dennaaa/LoRa_Node/CAMOutputs/Assembly/LoRa_Node_Schematic.txt

Stückliste exportiert aus C:/Users/sohns/Documents/EAGLE/projects/LoRa_Node/LoRa_Node_Schematic.sch am 22.01.2021 11:20

Qty Value              Device             Package                              Parts                            Description                                                                            AVAILABILITY BUILT_BY    COPYRIGHT                                                   DATASHEET                                                                             DESCRIPTION                                                                       DIGI-KEY_PART_NUMBER MANUFACTURER        MANUFACTURER-PN  MANUFACTURER_PART_NUMBER MANUFACTURER_PN MANUFACTURE_PN MF                  MP                 PACKAGE                    POPULARITY PRICE PURCHASE-URL                                                        SOURCELIBRARY               SPICEPREFIX TP_SIGNAL_NAME VENDOR           VOLTAGE
1                      LEDCHIP-LED0805    CHIP-LED0805                         LED1                             LED                                                                                                                                                                                                                                                                                                                                                                                                                                                                                                                                     68                                                                                                                                                                  
2                      PINHD-1X12-CB      1X12-CB                              JP1, JP2                         PIN HEADER                                                                                                                                                                                                                                                                                                                                                                                                                                                                                                                                                                                                                                                                                                  
1   0868AT43A0020E     0868AT43A0020E     XCVR_0868AT43A0020E                  ANT1                             Antenna 868mhz For Ti Cc11xx                                                                                                                                                                                                                                       868MHz Chip RF Antenna 858MHz ~ 878MHz -1dBi Solder Surface Mount                712-1399-1-ND                                                                                                     Johanson Technology 0868AT43A0020E     None                                        https://pricing.snapeda.com/search/part/0868AT43A0020E/?ref=eda                                                                                    
1   0p3                C-EUC0402          C0402                                C19                              CAPACITOR, European symbol                                                                                                                                                                                                                                                                                                                                               Johanson Technology                                           500R07S0R3BV4T                                                                                   18                                                                                                               C                                                  
1   100k               R-EU_R0402         R0402                                R6                               RESISTOR, European symbol                                                                                                                                                                                                                                                                                                                                                                                                                                                                                                               0                                                                                                                R                                                  
8   100n               C-EUC0402          C0402                                C4, C5, C6, C7, C8, C9, C11, C21 CAPACITOR, European symbol                                                                                                                                                                                                                                                                                                                                                                                                                                                                                                              18                                                                                                               C                                                  
3   10k                R-EU_R0402         R0402                                R4, R5, R7                       RESISTOR, European symbol                                                                                                                                                                                                                                                                                                                                                                                                                                                                                                               0                                                                                                                R                                                  
2   10u                C-EUC0603          C0603                                C15, C20                         CAPACITOR, European symbol                                                                                                                                                                                                                                                                                                                                                                                                                                                                                                              73                                                                                                               C                                                  
1   18n                INDUCTOR_0402_SMD  R0402                                L2                                                                                                                                                                                                                                                                                                                                                                                                        Johanson Technology                                           L-07C18NJV6T                                                                                                                                                                                                                                                         
1   1M                 R-EU_R0402         R0402                                R1                               RESISTOR, European symbol                                                                                                                                                                                                                                                                                                                                                                                                                                                                                                               0                                                                                                                R                                                  
1   1k                 R-EU_R0402         R0402                                R8                               RESISTOR, European symbol                                                                                                                                                                                                                                                                                                                                                                                                                                                                                                               0                                                                                                                R                                                  
3   1u                 C-EUC0402          C0402                                C10, C13, C14                    CAPACITOR, European symbol                                                                                                                                                                                                                                                                                                                                                                                                                                                                                                              18                                                                                                               C                                                  
2   20p                C-EUC0402          C0402                                C1, C2                           CAPACITOR, European symbol                                                                                                                                                                                                                                                                                                                                                                                                                                                                                                              18                                                                                                               C                                                  
1   32.768KHZ          ABS07-32.768KHZ-T  XTAL_ABS07-32.768KHZ-T               Y1                               ABS07 Series 32.768 kHz ±20 ppm 12.5 pF -40 to +85 °C SMT Low Profile Crystal                                                                                                                                                                                      32.768kHz ±20ppm Crystal 12.5pF 70 kOhms 2-SMD, No Lead                          535-9542-1-ND                                                                                                     Abracon             ABS07-32.768KHZ-T  SMD-2 Abracon LLC                           https://pricing.snapeda.com/search/part/ABS07-32.768KHZ-T/?ref=eda                                                                                 
1   330R               R-EU_R0402         R0402                                R3                               RESISTOR, European symbol                                                                                                                                                                                                                                                                                                                                                                                                                                                                                                               0                                                                                                                R                                                  
1   3p9                C-EUC0402          C0402                                C18                              CAPACITOR, European symbol                                                                                                                                                                                                                                                                                                                                               Johanson Technology                                                           500R07S3R9BV4T                                                                   18                                                                                                               C                                                  
1   4n7                C-EUC0805          C0805                                C3                               CAPACITOR, European symbol                                                                                                                                                                                                                                                                                                                                               KEMET               C0805C472KDRACTU                                                                                                                           88                                                                                                               C                                           1kV    
4   4u7                C-EUC0603          C0603                                C12, C16, C17, C22               CAPACITOR, European symbol                                                                                                                                                                                                                                                                                                                                                                                                                                                                                                              73                                                                                                               C                                                  
1   AP2112K-3.3        AP2112K-3.3        SOT95P285X140-5N                     U3                               AP2112 Series 0.6 A 3.3 V Fixed Output SMT LDO Linear Regulator - SOT23-5 Check prices Good                                                                                                                                                                        Linear Voltage Regulator IC 1 Output 600mA SOT-25                                                                                                                                                  Diodes Inc.         AP2112K-3.3        SOT-753 Diodes Inc.                   None  https://pricing.snapeda.com/search/part/AP2112K-3.3TRG1/?ref=eda                                                                                   
1   ATSAMD21G18A-AU    ATSAMD21G18A-AU    TQFP48_7X7MC_MCH                     U1                                                                                                                                   EMA_Molly   Copyright (C) 2018 Accelerated Designs. All rights reserved                                                                                                                                                                                                                                   ATSAMD21G18A-AU                                                                                                                                                                                                Microchip_2019-08-23_25                                Microchip               
1   B2B-PH-K-S(LF)(SN) B2B-PH-K-S(LF)(SN) JST_B2B-PH-K-S(LF)(SN)               J3                               PH Series 2 Position 2 mm Pitch Through Hole Top Entry Shrouded Header Check prices    Good                                                                                                                                                                        Connector Header Through Hole 2 position 0.079 (2.00mm)                                                                                                                                            JST Sales           B2B-PH-K-S(LF)(SN) None                                  None  https://pricing.snapeda.com/search/part/B2B-PH-K-S(LF)(SN)/?ref=eda                                                                                
1   BLM18PG471SN1D     BLM18PG471SN1D     IND_BLM18_0603_MUR                   L1                                                                                                                                   EMA_UL_Team                                                                                                                                                                                                                                                                                               BLM18PG471SN1D                                                                                                                                                                                                 Murata_2010-01-01IND_BLM                               MURATA                  
1   KMR231NGLFS        KMR231NGLFS        SW_KMR231NGLFS                       S1                               Tactile Switch SPST-NO Top Actuated Surface Mount  Check prices                        Good                                                                                                                                                                        Tactile Switch SPST-NO Top Actuated Surface Mount                                                                                                                                                  C&K Components      KMR231NGLFS        None                                  None  https://pricing.snapeda.com/search/part/KMR211NGLFS/?ref=eda                                                                                       
1   MBR120VLSFT1G      MBR120VLSFT1G      SDO_SOD-123FL_ONS                    D2                                                                                                                                   EMA_Cory    Copyright (C) 2018 Accelerated Designs. All rights reserved https://www.onsemi.com/pub/Collateral/MBR120VLSFT1-D.PDF                                                                                                                                                                          MBR120VLSFT1G                                                                                                                                                                                                  ON_Semiconductor_2020-09-15                            ON Semiconductor        
1   MCP73831-2ACI/OT   MCP73831-2ACI/OT   SOT95P280X145-5N                     U4                               Charge Management Controller Check prices                                              Good                                                                                                                                                                        Charger IC Lithium Ion/Polymer SOT-23-5                                                                                                                                                            Microchip           MCP73831-2ACI/OT   SOT-23 Microchip                      None  https://pricing.snapeda.com/search/part/MCP73831T-2ACI/OT/?ref=eda                                                                                 
2   MOUNT-HOLE2.5      MOUNT-HOLE2.5      MICROBUILDER_MOUNTINGHOLE_2.5_PLATED H1, H2                                                                                                                                                                                                                                                                                                                                                                                                                                                                                                                                                                                                                                                                                                                                       
1   PRTR5V0U2X,215     PRTR5V0U2X,215     SOT143B                              D1                               Ultra low capacitance double rail-to-rail ESD protection diode Check prices            Good                                                                                                                                                                        Clamp Ipp Tvs Diode Surface Mount SOT-143B                                                                                                                                                         Nexperia USA Inc.   PRTR5V0U2X,215     TO-253-4 Nexperia USA Inc.            None  https://pricing.snapeda.com/search/part/PRTR5V0U2X,215/?ref=eda                                                                                    
1   RFM95W-868S2SMALL  RFM95W-868S2SMALL  MICROBUILDER_RFMHCW_SMT              U2                               RFM95(W) - Low Power Long Range Transceiver Module V1.0 Check prices                                                                                                                                                                                                                                                                                                                                                                                                                                                                                                                                                                                                                                        
1   SHT40-AD1B-R2      SHT40-AD1B-R2      SHT4X_SEN                            U5                                                                                                                                   EMA_Cory    Copyright (C) 2018 Accelerated Designs. All rights reserved https://www.mouser.com/datasheet/2/682/Sensirion_10272020_Datasheet_SHT4x-1919523.pdf                                                                                                                                             SHT40-AD1B-R2                                                                                                                                                                                                  Add_to_database_2020-11-16                             Sensirion               
2   TPTP10R            TPTP10R            TP10R                                TP1, TP2                         Test pad                                                                                                                                                                                                                                                                                                                                                                                                                                                                                                                                3                                                                                                                                                                   
1   ZX62D-B-5PA8       ZX62D-B-5PA8       HIROSE_ZX62D-B-5PA8                  J1                               CONN RCPT USB Check prices                                                             Bad                                                                                                                                                                         USB - micro B USB 2.0 Receptacle Connector 5 Position Surface Mount, Right Angle  Through Hole                                                                                                                         Hirose             ZX62D-B-5PA8               None             None
