dennaaa/LoRa_Node/CAMOutputs/Assembly/PnP_LoRa_Node_Schematic_front.txt

C1	28.50	5.00	180.00	20p	C0402
C10	16.80	5.20	180.00	1u	C0402
C11	26.40	11.35	0.00	100n	C0402
C12	28.50	13.00	0.00	4u7	C0603
C2	28.50	7.55	180.00	20p	C0402
C21	26.40	10.20	0.00	100n	C0402
C22	38.25	4.65	90.00	4u7	C0603
C3	5.00	6.00	180.00	4n7	C0805
C4	14.40	2.15	270.00	100n	C0402
C6	32.00	13.63	90.00	100n	C0402
C8	12.60	5.80	270.00	100n	C0402
C9	17.50	3.80	180.00	100n	C0402
D1	8.00	11.83	0.00	PRTR5V0U2X,215	SOT143B
J1	2.79	11.50	270.00	ZX62D-B-5PA8	HIROSE_ZX62D-B-5PA8
L1	28.50	14.80	180.00	BLM18PG471SN1D	IND_BLM18_0603_MUR
LED1	3.60	17.30	90.00		CHIP-LED0805
R1	5.50	4.40	0.00	1M	R0402
R3	12.70	2.80	180.00	330R	R0402
S1	8.50	2.00	0.00	KMR231NGLFS	SW_KMR231NGLFS
TP1	20.10	4.00	0.00	TPTP10R	TP10R
TP2	21.60	4.00	0.00	TPTP10R	TP10R
U1	18.00	11.50	180.00	ATSAMD21G18A-AU	TQFP48_7X7MC_MCH
Y1	25.75	6.30	270.00	32.768KHZ	XTAL_ABS07-32.768KHZ-T
