dennaaa/LoRa_Node/LoRa_Node_Schematic.brd

## EAGLE design LoRa_Node_Schematic.brd (2021-01-22)

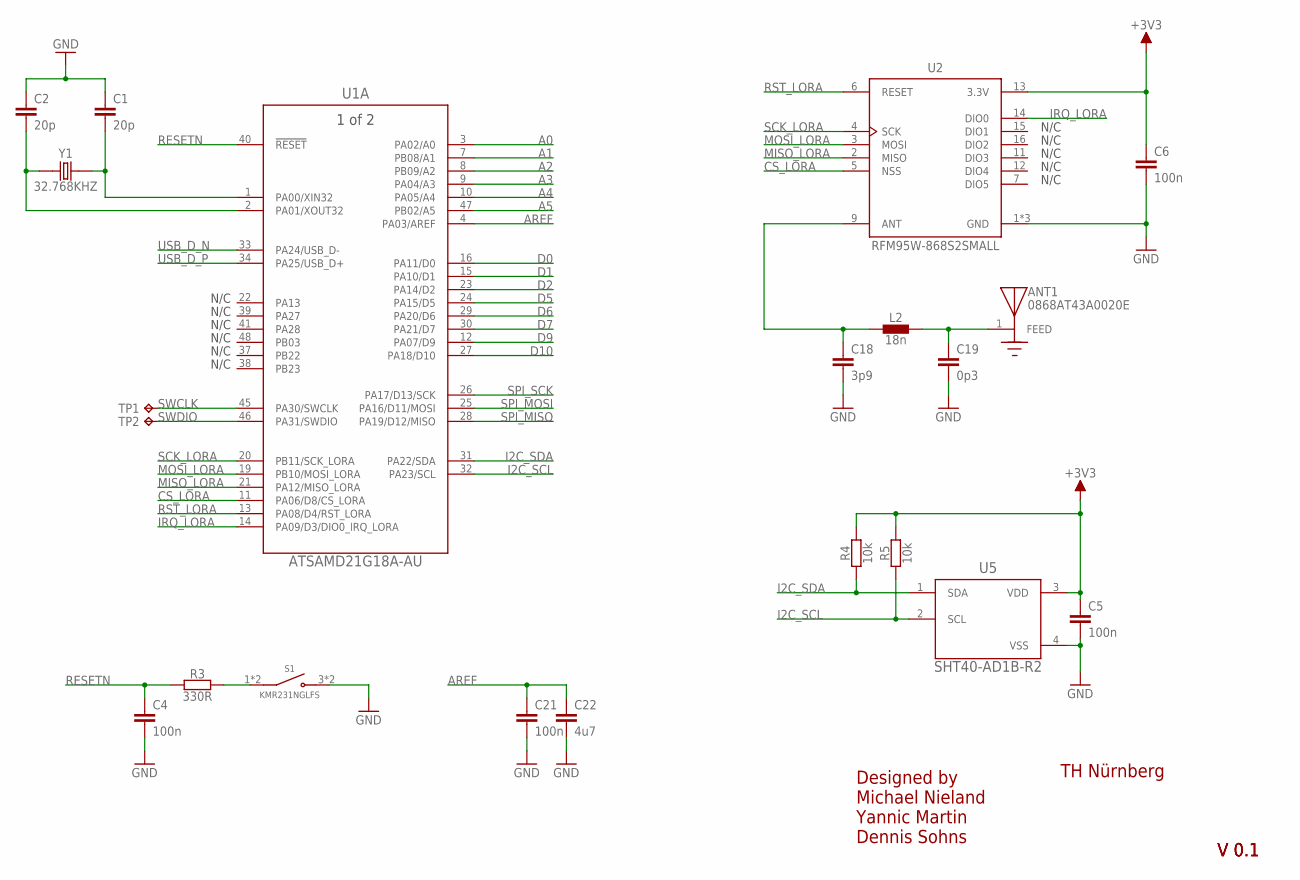
[picture p1: schematic LoRa_Node_Schematic.sch, sheet 1]

Parts:
ANT1: 0868AT43A0020E; XCVR_0868AT43A0020E
C1, C2: 20p; C0402
C4, C5, C6, C21: 100n; C0402
C18: 3p9; C0402; MANUFACTURE_PN 500R07S3R9BV4T
C19: 0p3; C0402; MANUFACTURER_PN 500R07S0R3BV4T
C22: 4u7; C0603
L2: 18n; R0402; MANUFACTURER_PN L-07C18NJV6T
R3: 330R; R0402
R4, R5: 10k; R0402
S1: KMR231NGLFS; SW_KMR231NGLFS
TP1, TP2: TPTP10R; TP10R
U1: ATSAMD21G18A-AU; TQFP48_7X7MC_MCH
U2: RFM95W-868S2SMALL; MICROBUILDER_RFMHCW_SMT
U5: SHT40-AD1B-R2; SHT4X_SEN
Y1: 32.768KHZ; XTAL_ABS07-32.768KHZ-T

Connections:
+3V3: C5.1, C6.1, R4.2, R5.2, U2.13 (3.3V), U5.3 (VDD); also elsewhere on the board
A0: U1.3 (PA02/A0); also elsewhere on the board
A1: U1.7 (PB08/A1); also elsewhere on the board
A2: U1.8 (PB09/A2); also elsewhere on the board
A3: U1.9 (PA04/A3); also elsewhere on the board
A4: U1.10 (PA05/A4); also elsewhere on the board
A5: U1.47 (PB02/A5); also elsewhere on the board
ANTENNA: C18.1, L2.1, U2.9 (ANT)
ANTENNA_L: ANT1.1, C19.1, L2.2
AREF: C21.1, C22.1, U1.4 (PA03/AREF); also elsewhere on the board
CS_LORA: U1.11 (PA06/D8/CS_LORA), U2.5 (NSS)
D0: U1.16 (PA11/D0); also elsewhere on the board
D1: U1.15 (PA10/D1); also elsewhere on the board
D2: U1.23 (PA14/D2); also elsewhere on the board
D5: U1.24 (PA15/D5); also elsewhere on the board
D6: U1.29 (PA20/D6); also elsewhere on the board
D7: U1.30 (PA21/D7); also elsewhere on the board
D9: U1.12 (PA07/D9); also elsewhere on the board
D10: U1.27 (PA18/D10); also elsewhere on the board
GND: C1.1, C2.1, C4.2, C5.2, C6.2, C18.2, C19.2, C21.2, C22.2, S1.3 (NO), S1.4 (NO), U2.1 (GND), U2.8 (GND), U2.10 (GND), U5.4 (VSS); also elsewhere on the board
I2C_SCL: R5.1, U1.32 (PA23/SCL), U5.2 (SCL); also elsewhere on the board
I2C_SDA: R4.1, U1.31 (PA22/SDA), U5.1 (SDA); also elsewhere on the board
IRQ_LORA: U1.14 (PA09/D3/DIO0_IRQ_LORA), U2.14 (DIO0)
MISO_LORA: U1.21 (PA12/MISO_LORA), U2.2 (MISO)
MOSI_LORA: U1.19 (PB10/MOSI_LORA), U2.3 (MOSI)
RESETN: C4.1, R3.1, U1.40 (!RESET)
RESETN_R: R3.2, S1.1 (COM), S1.2 (COM)
RST_LORA: U1.13 (PA08/D4/RST_LORA), U2.6 (RESET)
SCK_LORA: U1.20 (PB11/SCK_LORA), U2.4 (SCK)
SPI_MISO: U1.28 (PA19/D12/MISO); also elsewhere on the board
SPI_MOSI: U1.25 (PA16/D11/MOSI); also elsewhere on the board
SPI_SCK: U1.26 (PA17/D13/SCK); also elsewhere on the board
SWCLK: TP1.TP, U1.45 (PA30/SWCLK)
SWDIO: TP2.TP, U1.46 (PA31/SWDIO)
USB_D_N: U1.33 (PA24/USB_D-); also elsewhere on the board
USB_D_P: U1.34 (PA25/USB_D+); also elsewhere on the board
XIN32: C1.2, U1.1 (PA00/XIN32), Y1.2
XOUT32: C2.2, U1.2 (PA01/XOUT32), Y1.1

Notes on the sheet:
V 0.1
TH Nürnberg
Designed by Michael Nieland Yannic Martin Dennis Sohns
N/C

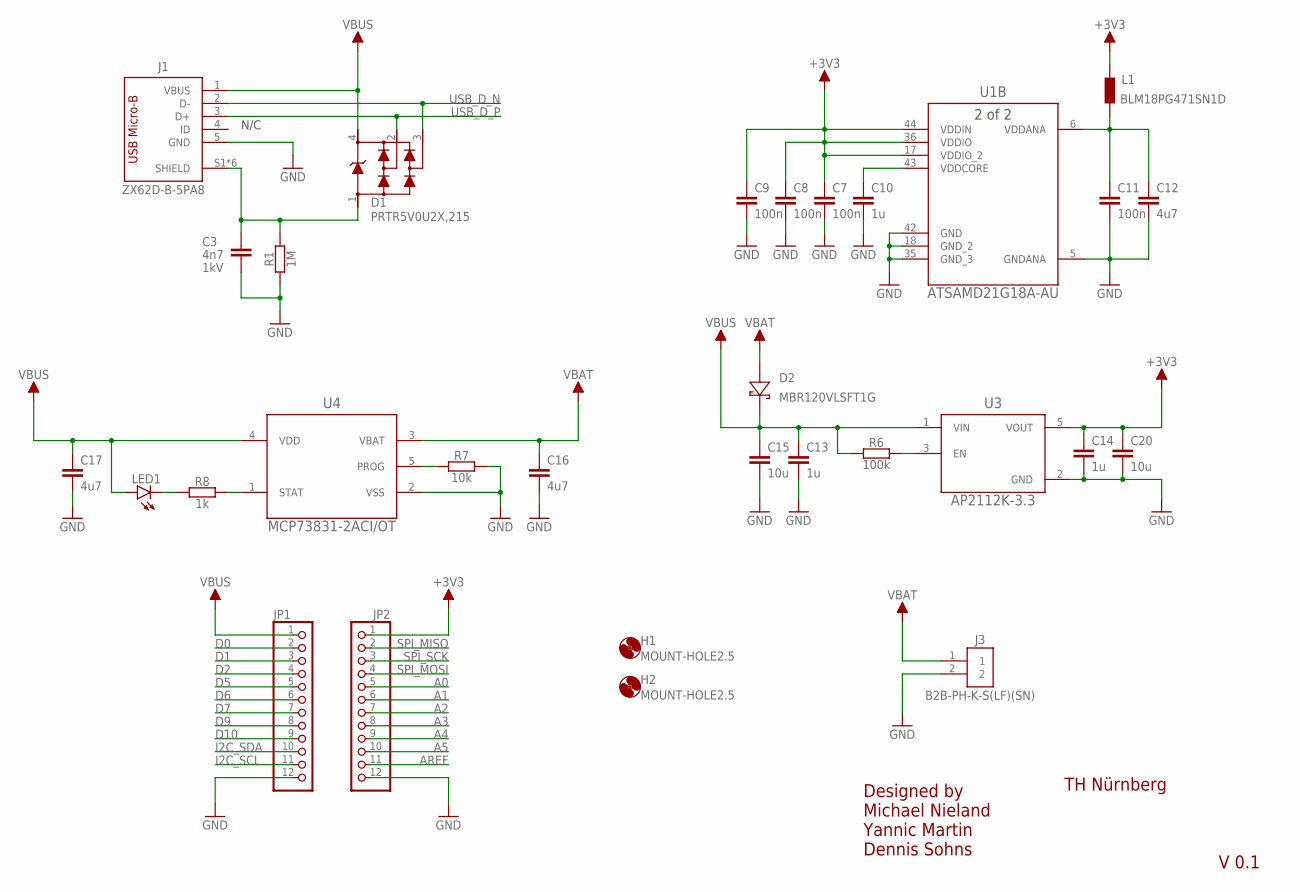
[picture p2: schematic LoRa_Node_Schematic.sch, sheet 2]

Parts:
C3: 4n7; C0805; VOLTAGE 1kV
C7, C8, C9, C11: 100n; C0402
C10, C13, C14: 1u; C0402
C12, C16, C17: 4u7; C0603
C15, C20: 10u; C0603
D1: PRTR5V0U2X,215; SOT143B
D2: MBR120VLSFT1G; SDO_SOD-123FL_ONS
H1, H2: MOUNT-HOLE2.5; MICROBUILDER_MOUNTINGHOLE_2.5_PLATED
J1: ZX62D-B-5PA8; HIROSE_ZX62D-B-5PA8
J3: B2B-PH-K-S(LF)(SN); JST_B2B-PH-K-S(LF)(SN)
JP1, JP2: PINHD-1X12-CB; 1X12-CB
L1: BLM18PG471SN1D; IND_BLM18_0603_MUR
LED1: LEDCHIP-LED0805; CHIP-LED0805
R1: 1M; R0402
R6: 100k; R0402
R7: 10k; R0402
R8: 1k; R0402
U1: ATSAMD21G18A-AU; TQFP48_7X7MC_MCH
U3: AP2112K-3.3; SOT95P285X140-5N
U4: MCP73831-2ACI/OT; SOT95P280X145-5N

Connections:
3V3_EN: R6.2, U3.3 (EN)
+3V3: C7.1, C8.1, C9.1, C14.1, C20.1, JP2.1, L1.1, U1.17 (VDDIO_2), U1.36 (VDDIO), U1.44 (VDDIN), U3.5 (VOUT); also elsewhere on the board
A0: JP2.5; also elsewhere on the board
A1: JP2.6; also elsewhere on the board
A2: JP2.7; also elsewhere on the board
A3: JP2.8; also elsewhere on the board
A4: JP2.9; also elsewhere on the board
A5: JP2.10; also elsewhere on the board
AREF: JP2.11; also elsewhere on the board
D0: JP1.2; also elsewhere on the board
D1: JP1.3; also elsewhere on the board
D2: JP1.4; also elsewhere on the board
D5: JP1.5; also elsewhere on the board
D6: JP1.6; also elsewhere on the board
D7: JP1.7; also elsewhere on the board
D9: JP1.8; also elsewhere on the board
D10: JP1.9; also elsewhere on the board
GND: C3.2, C7.2, C8.2, C9.2, C10.2, C11.2, C12.2, C13.2, C14.2, C15.2, C16.2, C17.2, C20.2, J1.5 (GND), J3.2, JP1.12, JP2.12, R1.1, R7.2, U1.5 (GNDANA), U1.18 (GND_2), U1.35 (GND_3), U1.42 (GND), U3.2 (GND), U4.2 (VSS); also elsewhere on the board
I2C_SCL: JP1.11; also elsewhere on the board
I2C_SDA: JP1.10; also elsewhere on the board
SPI_MISO: JP2.2; also elsewhere on the board
SPI_MOSI: JP2.4; also elsewhere on the board
SPI_SCK: JP2.3; also elsewhere on the board
USB_D_N: D1.3, J1.2 (D-); also elsewhere on the board
USB_D_P: D1.2, J1.3 (D+); also elsewhere on the board
USB_SHIELD: C3.1, D1.1, J1.S1 (SHIELD), J1.S2 (SHIELD), J1.S3 (SHIELD), J1.S4 (SHIELD), J1.S5 (SHIELD), J1.S6 (SHIELD), R1.2
VBAT: C16.1, D2.2 (12), J3.1, U4.3 (VBAT)
VBAT_PROG: R7.1, U4.5 (PROG)
VBAT_STAT: R8.2, U4.1 (STAT)
VBAT_STAT_R: LED1.C, R8.1
VBUS: C13.1, C15.1, C17.1, D1.4, D2.1 (11), J1.1 (VBUS), JP1.1, LED1.A, R6.1, U3.1 (VIN), U4.4 (VDD)
VDDANA: C11.1, C12.1, L1.2, U1.6 (VDDANA)
VDDCORE: C10.1, U1.43 (VDDCORE)

Notes on the sheet:
V 0.1
TH Nürnberg
Designed by Michael Nieland Yannic Martin Dennis Sohns
N/C

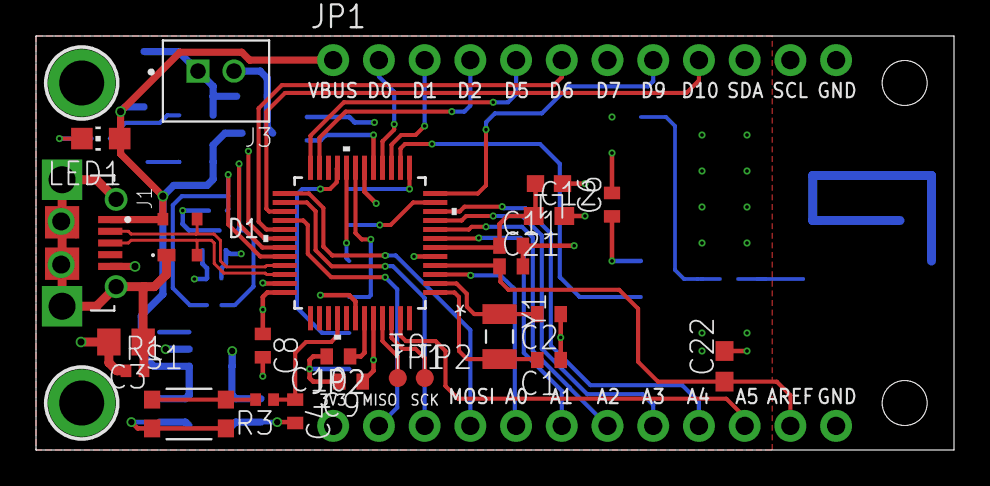
[picture p3: board LoRa_Node_Schematic.brd from above]

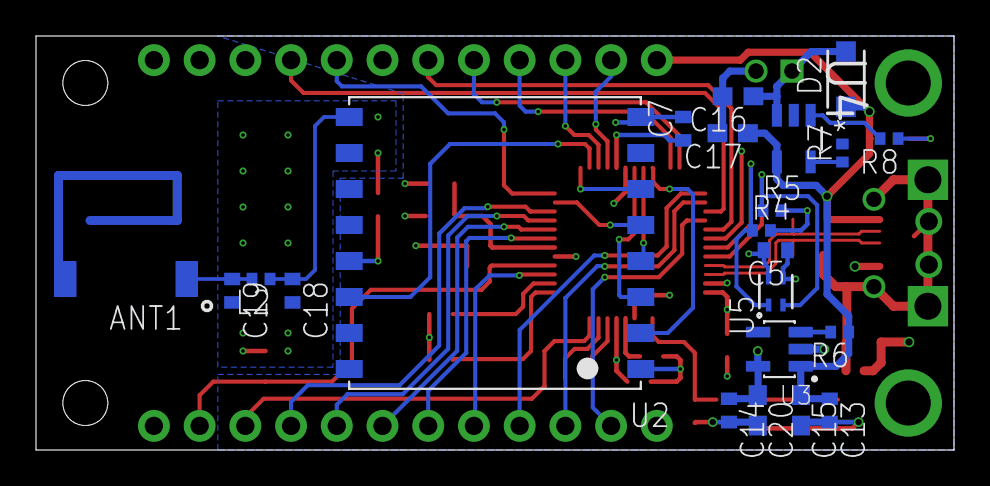
[picture p4: board LoRa_Node_Schematic.brd from below]

Board: 4 copper layers, 51.0 x 23.0 mm, 50 parts (22 on the bottom side), 47 nets.
