dennaaa/LoRa_Node/(commit log)

2020-12-21 update 201221
    [LoRa_Node_Schematic.sch]
2020-12-30 Review Version
    [Adafruit Feather M0 RFMxx.sch, LoRa_Node_Schematic.sch, MKRWAN1310V3.0.sch]
